lhr-solar/PS-PowerSelectorPCB/jlcpcb/production_files/BOM-PS-PowerSelectorPCB.csv

Description (Customer #) | P/N | Quantity
PTC 100mA fuse | SMD1210B005TF | 1
SMD fuse holder | 3568 | 1
Schottky diode | 1N5819HW-7-F | 2
1k 0603 resistor | CRCW06031K00FKEI | 5
XT30 2 pin board mount | XT30UPB-M | 2
XT60 2 pin board mount | XT60-M | 2
1x6 nanofit | 1053091206 | 1
Blue 0603 LED | XL-1608UBC-06A | 2
Red 0603 LED | NCD0603R1 | 3
1x2 nanofit | 1053091202 | 1
DPDT switch | 612-100DP1T2B4VS2QE | 1
