lhr-solar/PS-PowerSelectorPCB/Custom/3d/100DP1T2B4VS2QE.stp

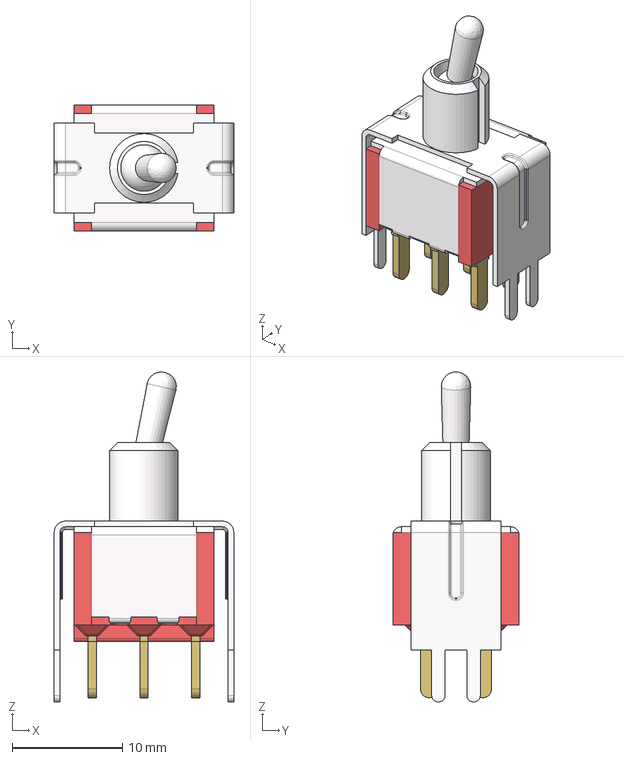
[picture p1: CAD file, 2025-12-27]
Custom/3d/100DP1T2B4VS2QE.stp
16.3 x 11.4 x 29.9 mm
