lhr-solar/PS-PowerSelectorPCB/PS-PowerSelectorPCB.step

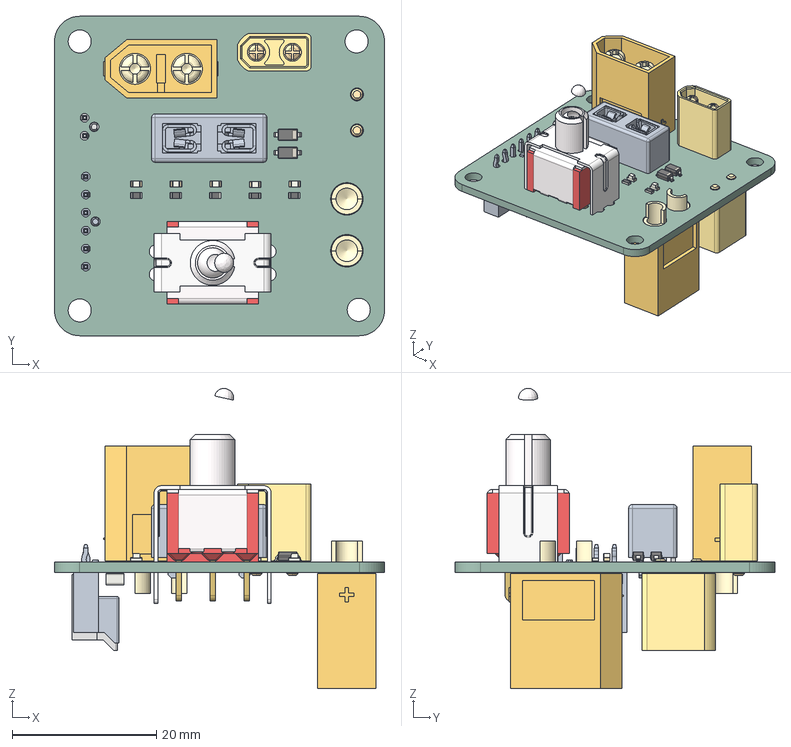
[picture p2: CAD file, 2025-12-27]
PS-PowerSelectorPCB.step
45.8 x 44.4 x 41.7 mm
R_0603_1608Metric x 5
LED_0603_1608Metric x 5
AMASS_XT60-M_1x02_P7.2mm_Vertical x 2
kicad_embedded_213B900F8FAA708CC9C99E13EC833D52 x 2
D_SOD-123 x 2
F3568-1
3557_rev.C x 2
kicad_embedded_4CB0A97DBE8F50E91DD7758067D94DB1
kicad_embedded_8DC7A9B76FF229F07B316F5D5C52BA0B
Fuse_1210_3225Metric
PS-PowerSelectorPCB_PCB
