lhr-solar/PS-PowerSelectorPCB/Custom/3d/3568.step

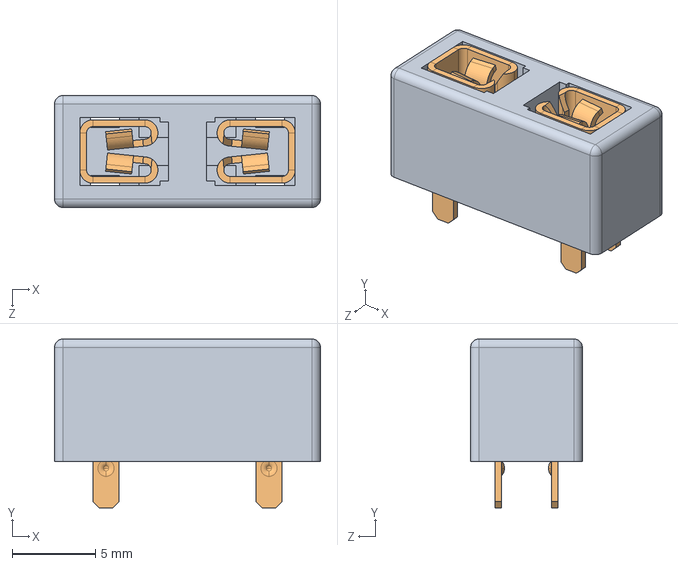
[picture p3: CAD file, 2025-12-27]
Custom/3d/3568.step
16.0 x 10.2 x 6.73 mm
F3568-1
3557_rev.C x 2
