lhr-solar/PS-PowerSelectorPCB/Custom/3d/XT30UPB-M--3DModel-STEP-510211.STEP

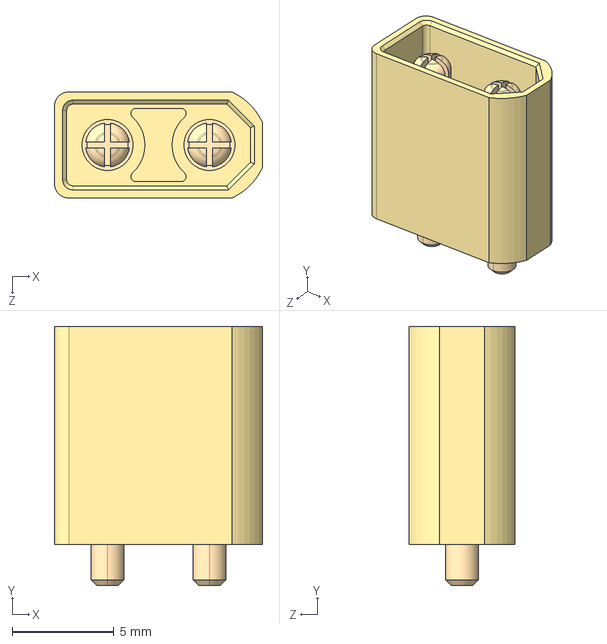
[picture p4: CAD file, 2025-12-27]
Custom/3d/XT30UPB-M--3DModel-STEP-510211.STEP
10.2 x 12.7 x 5.20 mm
