lhr-solar/PS-PowerSelectorPCB/Custom/3d/1053091106.stp

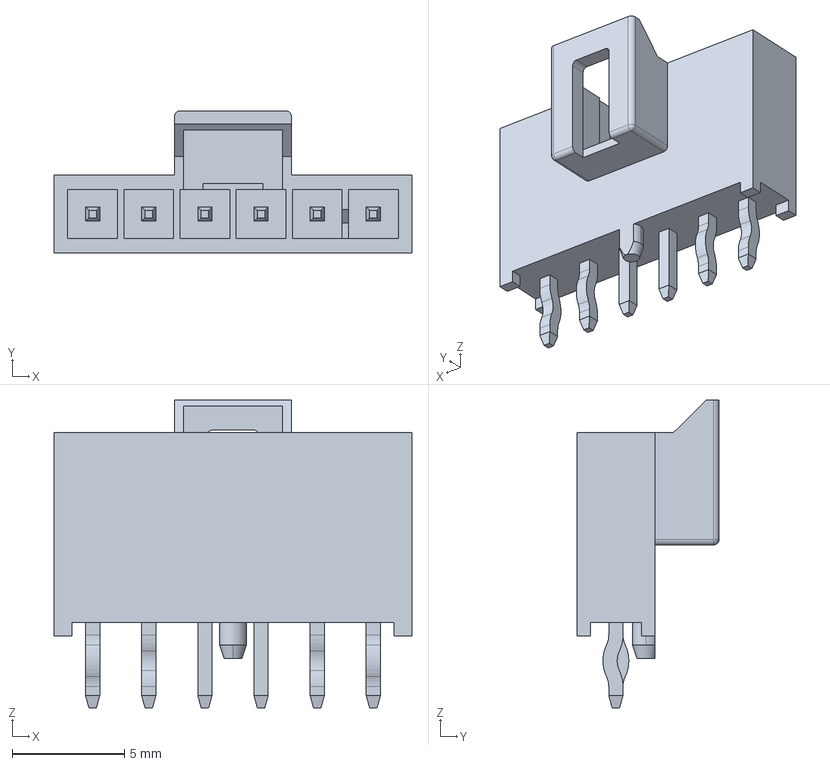
[picture p5: CAD file, 2025-12-27]
Custom/3d/1053091106.stp
15.9 x 6.34 x 13.7 mm
