lhr-solar/PS-PowerSelectorPCB/PS-PowerSelectorPCB.kicad_pcb

## KiCad design PS-PowerSelectorPCB.kicad_pcb (2025-12-27)

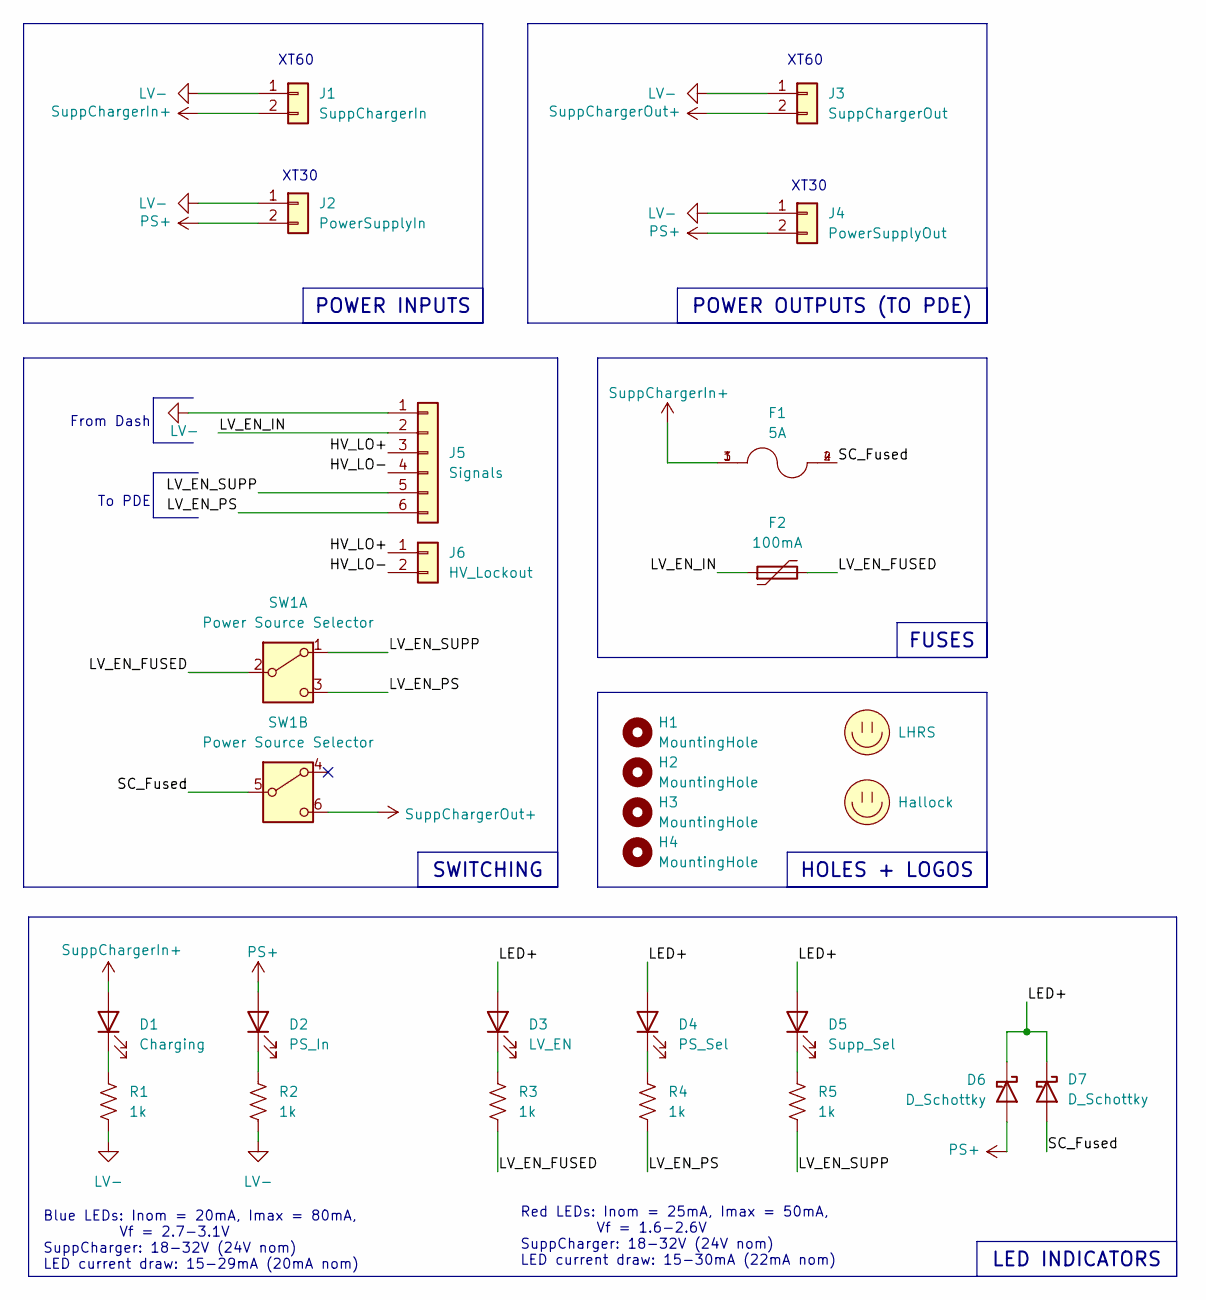
[picture p6: schematic PS-PowerSelectorPCB.kicad_sch]

Parts:
D1: Charging; LED_0603_1608Metric_Pad1.05x0.95mm_HandSolder
D2: PS_In; LED_0603_1608Metric_Pad1.05x0.95mm_HandSolder
D3: LV_EN; LED_0603_1608Metric_Pad1.05x0.95mm_HandSolder
D4: PS_Sel; LED_0603_1608Metric_Pad1.05x0.95mm_HandSolder
D5: Supp_Sel; LED_0603_1608Metric_Pad1.05x0.95mm_HandSolder
D6, D7: D_Schottky; D_SOD-123
F1: 5A; FUSE_3568
F2: 100mA; Fuse_1210_3225Metric_Pad1.42x2.65mm_HandSolder
H1, H2, H3, H4: MountingHole; MountingHole_3.2mm_M3
J1: SuppChargerIn; AMASS_XT60-M_1x02_P7.20mm_Vertical
J2: PowerSupplyIn; AMASS_XT30UPB-M_1x02_P5.0mm_Vertical
J3: SuppChargerOut; AMASS_XT60-M_1x02_P7.20mm_Vertical
J4: PowerSupplyOut; AMASS_XT30UPB-M_1x02_P5.0mm_Vertical
J5: Signals; Molex_Nano-Fit_105309-xx06_1x06_P2.50mm_Vertical
J6: HV_Lockout; Molex_Nano-Fit_105309-xx02_1x02_P2.50mm_Vertical
LOGO1: LHRS; LHRs_LOGO
LOGO2: Hallock; Hallock_Image_Tiny
R1, R2, R3, R4, R5: 1k; R_0603_1608Metric_Pad0.98x0.95mm_HandSolder
SW1: Power Source Selector; 100DP1T2B4VS2QE

Connections:
/HV_LO+: J5.3, J6.1
/HV_LO-: J5.4, J6.2
/LED+: D3.2 (A), D4.2 (A), D5.2 (A), D6.1 (K), D7.1 (K)
/LV_EN_FUSED: F2.2, R3.2, SW1.2 (B)
/LV_EN_IN: F2.1, J5.2
/LV_EN_PS: J5.6, R4.2, SW1.3 (C)
/LV_EN_SUPP: J5.5, R5.2, SW1.1 (A)
/SC_Fused: D7.2 (A), F1.2, F1.4, SW1.5 (B)
LV-: J1.1, J2.1, J3.1, J4.1, J5.1, R1.2, R2.2
unnamed: D1.1 (K), R1.1
unnamed: D2.1 (K), R2.1
unnamed: D3.1 (K), R3.1
unnamed: D4.1 (K), R4.1
unnamed: D5.1 (K), R5.1
PS+: D2.2 (A), D6.2 (A), J2.2, J4.2
SuppChargerIn+: D1.2 (A), F1.1, F1.3, J1.2
SuppChargerOut+: J3.2, SW1.6 (C)

Notes on the sheet:
Blue LEDs: Inom = 20mA, Imax = 80mA, Vf = 2.7-3.1V SuppCharger: 18-32V (24V nom) LED current draw: 15-29mA (20mA nom)
Red LEDs: Inom = 25mA, Imax = 50mA, Vf = 1.6-2.6V SuppCharger: 18-32V (24V nom) LED current draw: 15-30mA (22mA nom)
To PDE
XT60
XT30
From Dash
LED INDICATORS
SWITCHING
POWER INPUTS
FUSES
HOLES + LOGOS
POWER OUTPUTS (TO PDE)

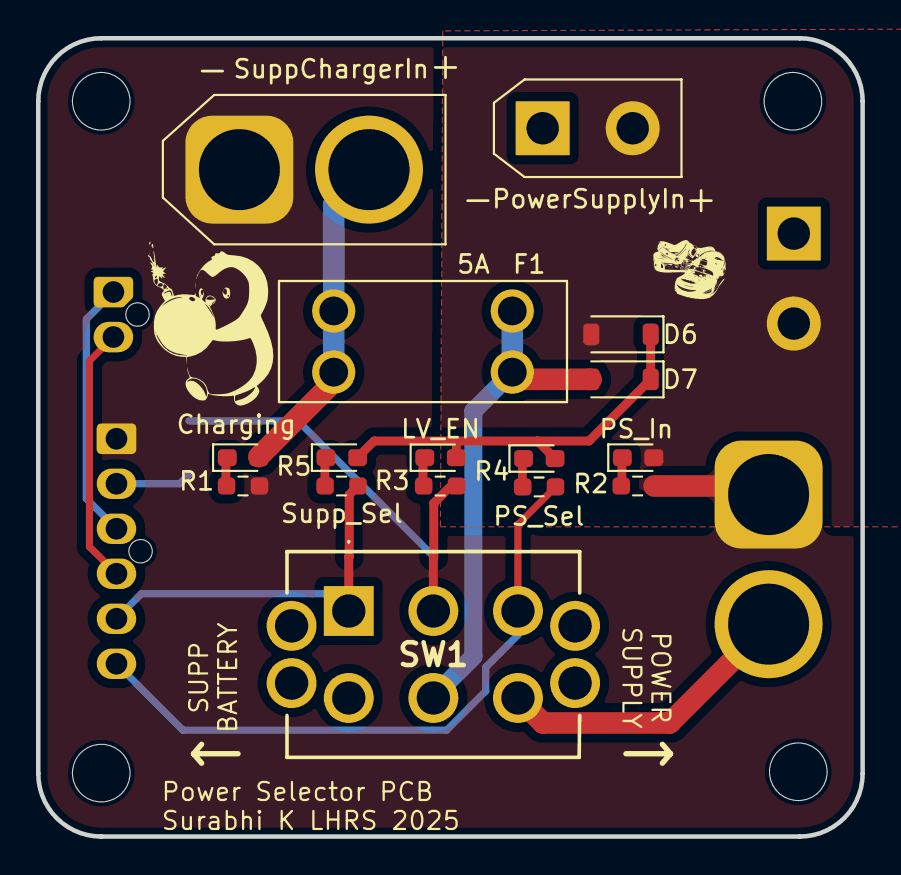
[picture p7: board PS-PowerSelectorPCB.kicad_pcb from above]

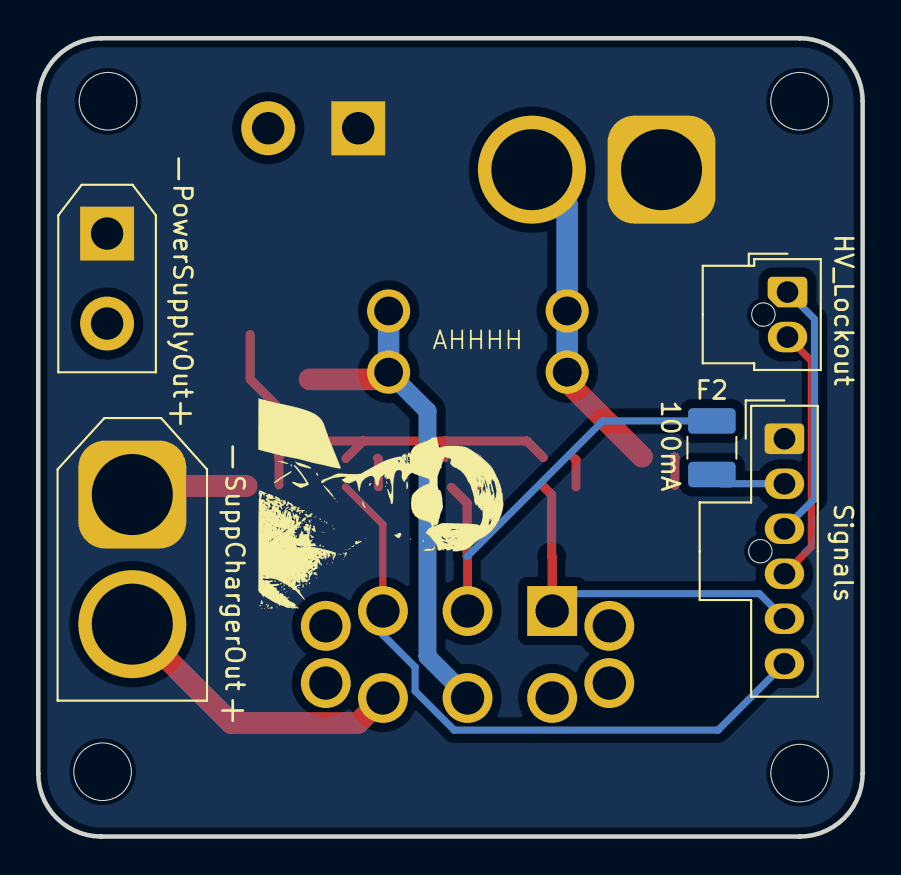
[picture p8: board PS-PowerSelectorPCB.kicad_pcb from below]

Board: 2 copper layers, 45.8 x 44.3 mm, 27 parts (6 on the bottom side), 17 nets.
