lhr-solar/PS-PowerSelectorPCB/(commit log)

2025-09-13 new pinouts
    [PS-PowerSelectorPCB.kicad_sch]
2025-10-12 initial schematic
    [3568.step, PS-PowerSelectorPCB.kicad_sch]
2025-10-14 initial layout
    [100DP1T2B4VS2QE.stp, PS-PowerSelectorPCB.kicad_pcb, PS-PowerSelectorPCB.kicad_sch, XT30UPB-M--3DModel-STEP-510211.STEP]
2025-10-14 fixed switch footprint + silkscreen
    [PS-PowerSelectorPCB.kicad_pcb, PS-PowerSelectorPCB.kicad_sch]
2025-10-14 fixed 3d models
    [1053091106.stp, PS-PowerSelectorPCB.kicad_pcb]
2025-10-14 gerbers + fixes
    [PS-PowerSelectorPCB-CuBottom.gbr, PS-PowerSelectorPCB-CuTop.gbr, PS-PowerSelectorPCB-EdgeCuts.gbr, PS-PowerSelectorPCB-MaskBottom.gbr, PS-PowerSelectorPCB-MaskTop.gbr, PS-PowerSelectorPCB-NPTH.drl, PS-PowerSelectorPCB-PTH.drl, PS-PowerSelectorPCB-SilkBottom.gbr]
2025-10-14 filled zones
    [PS-PowerSelectorPCB-CuBottom.gbr, PS-PowerSelectorPCB-CuTop.gbr, PS-PowerSelectorPCB-EdgeCuts.gbr, PS-PowerSelectorPCB-MaskBottom.gbr, PS-PowerSelectorPCB-MaskTop.gbr, PS-PowerSelectorPCB-NPTH.drl, PS-PowerSelectorPCB-PTH.drl, PS-PowerSelectorPCB-SilkBottom.gbr]
2025-10-18 added step
    [PS-PowerSelectorPCB.kicad_pcb, PS-PowerSelectorPCB.step]
